eSpark-Backup/ezlo-switchbox/Deliverables/Renderings/3D_Top_View.PNG

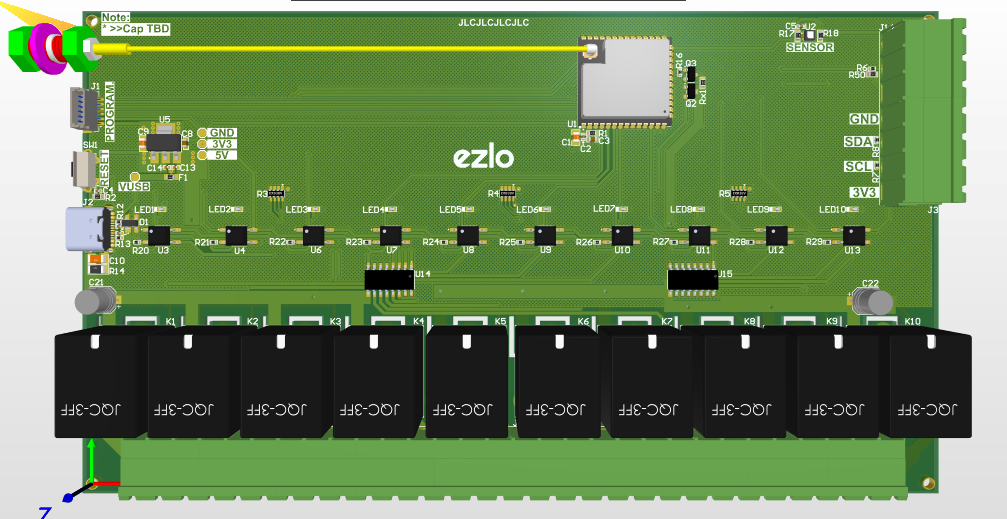
Deliverables/Renderings/3D_Top_View.PNG
