eSpark-Backup/ezlo-switchbox/Deliverables/Renderings/3D_Bottom_View.PNG

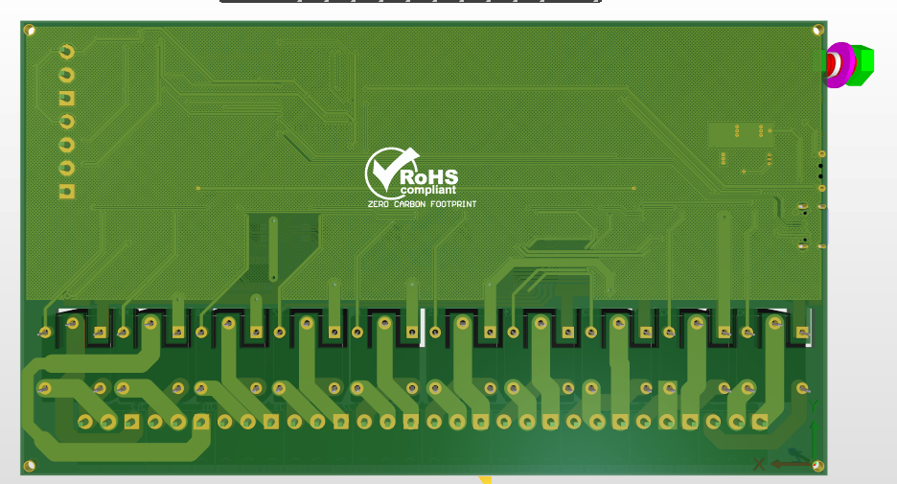
Deliverables/Renderings/3D_Bottom_View.PNG
