eSpark-Backup/ezlo-switchbox/README.md

# ezlo-switchbox
 To develop a basic Switch Box controlled by ESP32 for EzloPi compatability and has 10 relays to install and control distribution boxes
