eSpark-Backup/ezlo-switchbox/Deliverables/Renderings/2D_Top_View.PNG

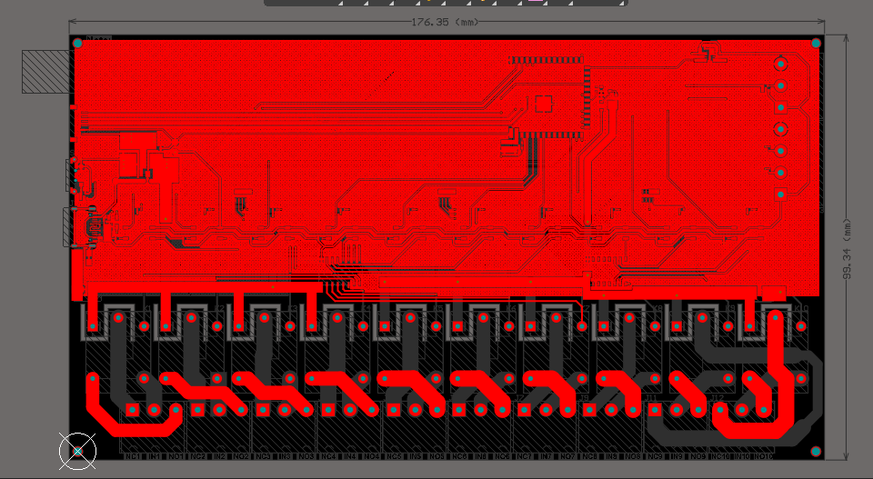
Deliverables/Renderings/2D_Top_View.PNG
