eSpark-Backup/ezlo-switchbox/Deliverables/Renderings/3D_Front Edge_View.PNG

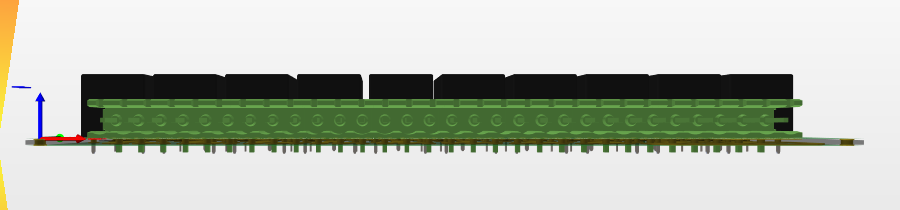
Deliverables/Renderings/3D_Front Edge_View.PNG
