eSpark-Backup/ezlo-switchbox/Deliverables/Renderings/3D_Isometric_View.PNG

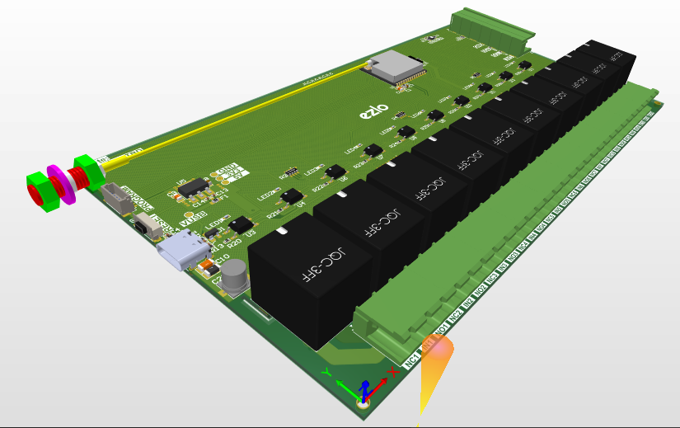
Deliverables/Renderings/3D_Isometric_View.PNG
