eSpark-Backup/ezlo-switchbox/Deliverables/BOM/eSpark_BOM.xlsx

Sheet: 10 Boards
 |  | Component list |  | Bill of Materials for Project [switch-box]
 |  | Source Data From: |  | switch-box
 |  | Project: |  | switch-box
 |  | Variant: |  | None
# | Item Type | Designator | Description | Footprint | Manufacturer Part Number | Manufacturer | Alternate Part Number | LCSC Part Number | Value | Quantity | Quantity (10 Boards) | MOQ (10 Boards) | Links | Unit Cost (10 Boards) | Total Cost (10 Boards) | Remarks | Reviewer Remarks
1 | Capacitor | C1, C9 | CAP CER 22UF 25V X5R 0805 | Cap-0805 | CL21A226MAYNNNE | Samsung | - | C602037 | 22uF | 2 | 20 | 40 | LCSC (https://www.lcsc.com/product-detail/Multilayer-Ceramic-Capacitors-MLCC-SMD-SMT_Samsung-Electro-Mechanics-CL21A226MAYNNNE_C602037.html) | $0.0239 | $0.9560
2 | Capacitor | C2, C4, C5 | CAP CER 0.1UF 50V X5R 0402 | Cap-0402 | ~~C1005X5R1H104K050BB~~ | TDK | CC0402KRX7R9BB104 | C131394 | 0.1uF | 3 | 30 | 100 | LCSC (https://www.lcsc.com/product-detail/Multilayer-Ceramic-Capacitors-MLCC-SMD-SMT_YAGEO-CC0402KRX7R9BB104_C131394.html) | $0.0030 | $0.3000
3 | Capacitor | C3 | CAP CER 1UF 25V X5R 0603 | Cap-0603 | CC0603KRX5R8BB105 | Yageo | - | C14664 | 1uF | 1 | 10 | 100 | LCSC (https://www.lcsc.com/product-detail/Multilayer-Ceramic-Capacitors-MLCC-SMD-SMT_YAGEO-CC0603KRX5R8BB105_C14664.html) | $0.0046 | $0.4600
4 | Capacitor | C8 | CAP CER 10UF 25V X5R 0603 | Cap-0603 | ~~C1608X5R1E106M080AC~~ | TDK | CL10A106MA8NRNC | C96446 | 10uF | 1 | 10 | 20 | LCSC (https://www.lcsc.com/product-detail/Multilayer-Ceramic-Capacitors-MLCC-SMD-SMT_Samsung-Electro-Mechanics-CL10A106MA8NRNC_C96446.html) | $0.0234 | $0.4680
5 | Capacitor | C10 | CAP CER 4700PF 1KV X7R 1206 | Cap-1206 | CC1206KKX7RCBB472 | Yageo | - | C107198 | 4.7nF | 1 | 10 | 50 | LCSC (https://www.lcsc.com/product-detail/Multilayer-Ceramic-Capacitors-MLCC-SMD-SMT_YAGEO-CC1206KKX7RCBB472_C107198.html) | $0.0156 | $0.7800
6 | Capacitor | C11, C12 | DO Not Mount | Cap-0402 | - | - | - | - | - | 2 | 20 | - | - | - | - | - | -
7 | Capacitor | C13 | CAP CER 1UF 10V X5R 0402 | Cap-0402 | CC0402KRX5R6BB105 | Yageo | - | C106254 | 1uF | 1 | 10 | 100 | LCSC (https://www.lcsc.com/product-detail/Multilayer-Ceramic-Capacitors-MLCC-SMD-SMT_YAGEO-CC0402KRX5R6BB105_C106254.html) | $0.0020 | $0.2000
8 | Capacitor | C14 | CAP CER 4.7UF 10V X5R 0402 | Cap-0402 | CC0402KRX5R6BB475 | Yageo | - | C326586 | 4.7uF | 1 | 10 | 50 | LCSC (https://www.lcsc.com/product-detail/Multilayer-Ceramic-Capacitors-MLCC-SMD-SMT_YAGEO-CC0402KRX5R6BB475_C326586.html) | $0.0139 | $0.6950
9 | Capacitor | C21, C22 | -45℃~+105℃ 2000hrs@105℃ 47uF 5.4mm 16V 5mm ±20% SMD,D5xL5.4mm Aluminum Electrolytic Capacitors - SMD ROHS | SMD,D5xL5.4mm | RVT1C470M0505 | ROQANG | - | C72515 | 47uF | 2 | 20 | 40 | LCSC (https://www.lcsc.com/product-detail/Aluminum-Electrolytic-Capacitors-SMD_ROQANG-RVT1C470M0505_C72515.html) | $0.0275 | $1.1000
10 | Diode | D1 | ESD Suppressor TVS 5.5V 4-Pin(3+Tab) SOT-143 T/R | SOT-143-4_ | SP0503BAHTG | Littelfuse | - | C3029025 | - | 1 | 10 | 15 | LCSC (https://www.lcsc.com/product-detail/ESD-Protection-Devices_MSKSEMI-SP0503BAHTG-MS_C3029025.html) | $0.0654 | $0.9810
11 | Fuse | F1 | 6V 1A 50A 1W -40℃~+85℃ 2A 9mΩ 0.5s 80mΩ 0603 Resettable Fuses ROHS | fuse-0603 | BSMD0603L-100 | BHFUSE | - | C2757929 | - | 1 | 10 | 15 | LCSC (https://www.lcsc.com/product-detail/Resettable-Fuses_BHFUSE-BSMD0603L-100_C2757929.html) | $0.0716 | $1.0740
12 | JST Connector | J1 | 1x6P SH 1 1mm 6 SMD,P=1mm Wire To Board / Wire To Wire Connector ROHS | Custom | C145963 | BOOMELE | - | C145963 | - | 1 | 10 | 12 | LCSC (https://www.lcsc.com/product-detail/Wire-To-Board-Wire-To-Wire-Connector_BOOMELE-Boom-Precision-Elec-C145963_C145963.html) | $0.0720 | $0.8640
13 | USB Connector | J2 | 250mA 1 16 Female Type-C SMD USB Connectors ROHS | Custom | TYPE-C-31-M-12 | Korean Hroparts Elec | - | C165948 | - | 1 | 10 | 15 | LCSC (https://www.lcsc.com/product-detail/USB-Connectors_Korean-Hroparts-Elec-TYPE-C-31-M-12_C165948.html) | $0.2276 | $3.4140
14 | Terminal Block | J3 | 450V 17.5A 4 Bend -40℃~+105℃ 1 5.08mm Green Board Edge/Receptacle-Open Push-Pull,P=5.08mm Pluggable System Terminal Block ROHS | Custom | DB2ER-5.08-4P-GN | DIBO | - | C395752 | - | 1 | 10 | 15 | LCSC (https://www.lcsc.com/product-detail/Pluggable-System-Terminal-Block_DIBO-DB2ER-5-08-4P-GN_C395752.html) | $0.0656 | $0.9840
15 | Terminal Block | J4, J5, J6, J7, J8, J9, J10, J11, J12, J13, J14 | 3 Bend 1 5.08mm Green Board Edge/Receptacle-Open Push-Pull,P=5.08mm Pluggable System Terminal Block ROHS | Custom | WJ2EDGR-5.08-3P | Ningbo Kangnex Elec | - | C70914 | - | 11 | 110 | 120 | LCSC (https://www.lcsc.com/product-detail/Pluggable-System-Terminal-Block_Ningbo-Kangnex-Elec-WJ2EDGR-5-08-3P_C70914.html) | $0.0461 | $5.5320
16 | Relay | K1, K2, K3, K4, K5, K6, K7, K8, K9, K10 | AgCdO 5V 10A SPDT (1 Form C) Electromagnetic Relay-Single Coil Plugin Power Relays ROHS | Custom | JQC-3FF/005-1ZS(551) | HF(Xiamen Hongfa Electroacoustic) | - | C9221 | - | 10 | 100 | 105 | LCSC (https://www.lcsc.com/product-detail/Power-Relays_HF-Xiamen-Hongfa-Electroacoustic-JQC-3FF-005-1ZS-551_C9221.html) | $0.2578 | $27.0690
17 | LED | LED1, LED2, LED3, LED4, LED5, LED6, LED7, LED8, LED9, LED10 | Green 520~535nm 0402 Light Emitting Diodes (LED) RoHS | LED-0402 | 16-213/GHC-YR1S1/3T | Everlight Elec | - | C74338 | - | 10 | 100 | 110 | LCSC (https://www.lcsc.com/product-detail/Light-Emitting-Diodes-LED_Everlight-Elec-16-213-GHC-YR1S1-3T_C74338.html) | $0.0679 | $7.4690
18 | Test Point | P2, P3, P14, P15 | Test Point ON | Custom | Test-point | - | - | - | - | 4 | 40 | - | - | - | -
19 | Mosfet | Q2 | MOSFET P-CH 12V 2.6A SUPERSOT3 | SOT-23 | FDN306P | ON Semiconductor / Fairchild | - | C725031 | - | 1 | 10 | 15 | LCSC (https://www.lcsc.com/product-detail/MOSFETs_VBsemi-Elec-FDN306P-VB_C725031.html) | $0.0674 | $1.0110
20 | Mosfet | Q3 | Trans Gp Bjt NPN 25V 1.5A 300MW 3-PIN SOT-23 T/r | SOT-23 | SS8050-G | Comchip | - | C105433 | - | 1 | 10 | 50 | LCSC (https://www.lcsc.com/product-detail/Bipolar-Transistors-BJT_Jiangsu-Changjing-Electronics-Technology-Co-Ltd-S8050_C105433.html) | $0.0147 | $0.7350
21 | Resistor | R1, R2, R17, R18, R50, Rx1 | RES 10K OHM 1% 1/10W 0603 | RES-0603 | RC0603FR-0710KL | YAGEO | - | C98220 | 10K | 6 | 60 | 100 | LCSC (https://www.lcsc.com/product-detail/Chip-Resistor-Surface-Mount_YAGEO-RC0603FR-0710KL_C98220.html) | $0.0010 | $0.1000
22 | Resistor Array | R3, R4, R5 | 4 8 ±5% 330Ω 62.5mW ±200ppm/℃ 0603x4 Resistor Networks & Arrays ROHS | Resistor 0603x4 | 4D03WGJ0331T5E | UNI-ROYAL(Uniroyal Elec) | - | C12018 | 330R | 3 | 30 | 100 | LCSC (https://www.lcsc.com/product-detail/span-style-background-color-ff0-Resistor-span-Networks-Arrays_UNI-ROYAL-Uniroyal-Elec-4D03WGJ0331T5E_C12018.html) | $0.0069 | $0.6900
23 | Resistor | R6, R7, R8 | RES SMD 47 OHM 1% 1/10W 0402 | Res-0402 | ERJ-2RKF47R0X | Panasonic | - | C413056 | 47R | 3 | 30 | 50 | LCSC (https://www.lcsc.com/product-detail/Chip-Resistor-Surface-Mount_PANASONIC-ERJ2RKF47R0X_C413056.html) | $0.0078 | $0.3900
24 | Resistor | R12, R13 | RES SMD 5.1 KOHM 1% 1/5W 0402 | Res-0402 | ~~ERJ-PA2F5101X~~ | Panasonic | RC0402JR-075K1L | C105873 | 5.1K | 2 | 20 | 100 | LCSC (https://www.lcsc.com/product-detail/Chip-span-style-background-color-ff0-Resistor-span-Surface-Mount_YAGEO-RC0402JR-075K1L_C105873.html) | $0.0005 | $0.0500
25 | Resistor | R14 | RES SMD 1M OHM 1% 1/10W 0603 | Res-0603 | RC0603FR-071ML | Yageo | - | C105578 | 1M | 1 | 10 | 100 | LCSC (https://www.lcsc.com/product-detail/Chip-Resistor-Surface-Mount_YAGEO-RC0603FR-071ML_C105578.html) | $0.0014 | $0.1400
26 | Resistor | R16 | RES 100K OHM 1% 1/16W 0402 | Res-0402 | RC0402FR-07100KL | Yageo | - | C60491 | 100K | 1 | 10 | 100 | LCSC (https://www.lcsc.com/product-detail/Chip-Resistor-Surface-Mount_YAGEO-RC0402FR-07100KL_C60491.html) | $0.0005 | $0.0500
27 | Resistor | R20, R21, R22, R23, R24, R25, R26, R27, R28, R29 | RES 100 OHM 1% 1/16W 0402 | Res-0402 | RC0402FR-07100RL | Yageo | - | C2935235 | 100R | 10 | 100 | 200 | LCSC (https://www.lcsc.com/product-detail/Chip-Resistor-Surface-Mount_YAGEO-RC0402FR-07100RL_C2935235.html) | $0.0007 | $0.1400
28 | Switch | SW1 | 3.5mm 3.5mm SMDSplicing Black Rectangle button 50mA Surface Mount 7mm SPST 100MΩ 20000 12V 250gf@±50gf SMD Tactile Switches ROHS | Custom | YTS-B003-2A | YIYUAN | - | C2910695 | - | 1 | 10 | 20 | LCSC (https://www.lcsc.com/product-detail/Tactile-Switches_YIYUAN-YTS-B003-2A_C2910695.html) | $0.0180 | $0.3600
29 | Module | U1 | RF TXRX MOD WIFI SURFACE MOUNT | 41-SMD UFL Module | ESP32-S3-WROOM-1U-N4 | Espressif Systems | - | C2980296 | - | 1 | 10 | 11 | LCSC (https://www.lcsc.com/product-detail/WiFi-Modules_Espressif-Systems-ESP32-S3-WROOM-1U-N4_C2980296.html) | $3.3553 | $36.9083
30 | Temperature & Humidity Sensor | U2 | DFN-6-EP(2x2) Temperature and Humidity Sensor ROHS | DFN-6-EP(2x2) | GXHTC3 | GXCAS | - | C2837688 | - | 1 | 10 | 11 | LCSC (https://www.lcsc.com/product-detail/Temperature-and-Humidity-Sensor_GXCAS-GXHTC3_C2837688.html) | $0.7096 | $7.8056
31 | Optocoupler | U3, U4, U6, U7, U8, U9, U10, U11, U12, U13 | Optoisolator Transistor Output 3750Vrms 1 Channel | SOP-4_2.54 | IS181GB | Isocom | - | C84196 | - | 10 | 100 | 105 | LCSC (https://www.lcsc.com/product-detail/Optocouplers-Phototransistor-Output_Isocom-Components-IS181GB_C84196.html) | $0.1175 | $12.3375
32 | IC | U5 | IC REG LINEAR 3.3V 1.2A SOT223 | SOT- 223 | LDL1117S33R | STMicroelectronics | - | C435835 | - | 1 | 10 | 15 | LCSC (https://www.lcsc.com/product-detail/Linear-Voltage-Regulators-LDO_STMicroelectronics-LDL1117S33R_C435835.html) | $0.3513 | $5.2695
33 | IC | U14, U15 | TRANS 7NPN DARL 50V 0.5A 16SOIC | 16-SOIC | ULN2003AD | Mixic | - | C181730 | - | 2 | 20 | 25 | LCSC (https://www.lcsc.com/product-detail/Darlington-Transistor-Arrays_Mixic-ULN2003A_C181730.html) | $0.0812 | $2.0300
34 | Terminal Block | - | 3 1 5.08mm Green Plug P=5.08mm Pluggable System Terminal Block ROHS | Custom | WJ2EDGK-5.08-3P | Ningbo Kangnex Elec | - | C71371 | - | 11 | 110 | 115 | LCSC (https://www.lcsc.com/product-detail/Pluggable-System-span-style-background-color-ff0-Terminal-span-Block_Ningbo-Kangnex-Elec-WJ2EDGK-5-08-3P_C71371.html) | $0.1517 | $17.4455
35 | Terminal Block | - | 320V 15A 4 2.5 1 12~24 5.08mm Green Plug P=5.08mm Pluggable System Terminal Block ROHS | Custom | KF2EDGK-5.08-4P-AA | Cixi Kefa Elec | - | C440882 | - | 1 | 10 | 15 | LCSC (https://www.lcsc.com/product-detail/Pluggable-System-span-style-background-color-ff0-Terminal-span-Block_Cixi-Kefa-Elec-KF2EDGK-5-08-4P-AA_C440882.html) | $0.3461 | $5.1915
36 | SMA Cable | - | 100mm IPEX to SMA 1Gen - Radio Frequency Cable ROHS | Custom | BWIPX1-SMA-1.13L100 | BAT WIRELESS | - | C784403 | - | 1 | 10 | 11 | LCSC (https://www.lcsc.com/product-detail/_BAT-WIRELESS-_C784403.html) | $0.6832 | $7.5152
37 | Antenna | - | 13x200mm Antennas ROHS | Custom | TX2400-JKD-20 | ZIISOR | - | C454911 | - | 1 | 10 | 11 | LCSC (https://www.lcsc.com/product-detail/_ZIISOR-_C454911.html) | $0.9610 | $10.5710
 |  |  |  |  |  |  |  |  |  |  |  | Total Component Cost |  |  | $161.09
 |  |  |  |  |  |  |  |  |  |  |  | Single Board Cost |  |  | $16.11

Sheet: 1000 Boards
 |  | Component list |  | Bill of Materials for Project [switch-box.PrjPcb]
 |  | Source Data From: |  | switch-box
 |  | Project: |  | switch-box
 |  | Variant: |  | None
# | Item Type | Designator | Description | Footprint | Manufacturer Part Number | Manufacturer | Alternate Part Number | LCSC Part Number | Value | Quantity | Quantity (1000 Boards) | MOQ (1000 Boards) | Links | Unit Cost (1000 Boards) | Total Cost (1000 Boards) | Remarks | Reviewer Remarks
1 | Capacitor | C1, C9 | CAP CER 22UF 25V X5R 0805 | Cap-0805 | CL21A226MAYNNNE | Samsung | - | C602037 | 22uF | 2 | 2000 | 2060 | LCSC (https://www.lcsc.com/product-detail/Multilayer-Ceramic-Capacitors-MLCC-SMD-SMT_Samsung-Electro-Mechanics-CL21A226MAYNNNE_C602037.html) | $0.0142 | $29.2520
2 | Capacitor | C2, C4, C5 | CAP CER 0.1UF 50V X5R 0402 | Cap-0402 | ~~C1005X5R1H104K050BB~~ | TDK | CC0402KRX7R9BB104 | C131394 | 0.1uF | 3 | 3000 | 3100 | LCSC (https://www.lcsc.com/product-detail/Multilayer-Ceramic-Capacitors-MLCC-SMD-SMT_YAGEO-CC0402KRX7R9BB104_C131394.html) | $0.0020 | $6.2000
3 | Capacitor | C3 | CAP CER 1UF 25V X5R 0603 | Cap-0603 | CC0603KRX5R8BB105 | Yageo | - | C14664 | 1uF | 1 | 1000 | 1100 | LCSC (https://www.lcsc.com/product-detail/Multilayer-Ceramic-Capacitors-MLCC-SMD-SMT_YAGEO-CC0603KRX5R8BB105_C14664.html) | $0.0036 | $3.9600
4 | Capacitor | C8 | CAP CER 10UF 25V X5R 0603 | Cap-0603 | ~~C1608X5R1E106M080AC~~ | TDK | CL10A106MA8NRNC | C96446 | 10uF | 1 | 1000 | 1060 | LCSC (https://www.lcsc.com/product-detail/Multilayer-Ceramic-Capacitors-MLCC-SMD-SMT_Samsung-Electro-Mechanics-CL10A106MA8NRNC_C96446.html) | $0.0234 | $24.8040
5 | Capacitor | C10 | CAP CER 4700PF 1KV X7R 1206 | Cap-1206 | CC1206KKX7RCBB472 | Yageo | - | C107198 | 4.7nF | 1 | 1000 | 1050 | LCSC (https://www.lcsc.com/product-detail/Multilayer-Ceramic-Capacitors-MLCC-SMD-SMT_YAGEO-CC1206KKX7RCBB472_C107198.html) | $0.0127 | $13.3350
6 | Capacitor | C11, C12 | DO Not Mount | Cap-0402 | - | - | - | - | - | 2 | 2000 | - | - | - | - | - | -
7 | Capacitor | C13 | CAP CER 1UF 10V X5R 0402 | Cap-0402 | CC0402KRX5R6BB105 | Yageo | - | C106254 | 1uF | 1 | 1000 | 1100 | LCSC (https://www.lcsc.com/product-detail/Multilayer-Ceramic-Capacitors-MLCC-SMD-SMT_YAGEO-CC0402KRX5R6BB105_C106254.html) | $0.0016 | $1.7600
8 | Capacitor | C14 | CAP CER 4.7UF 10V X5R 0402 | Cap-0402 | CC0402KRX5R6BB475 | Yageo | - | C326586 | 4.7uF | 1 | 1000 | 1050 | LCSC (https://www.lcsc.com/product-detail/Multilayer-Ceramic-Capacitors-MLCC-SMD-SMT_YAGEO-CC0402KRX5R6BB475_C326586.html) | $0.0113 | $11.8650
9 | Capacitor | C21, C22 | -45℃~+105℃ 2000hrs@105℃ 47uF 5.4mm 16V 5mm ±20% SMD,D5xL5.4mm Aluminum Electrolytic Capacitors - SMD ROHS | SMD,D5xL5.4mm | RVT1C470M0505 | ROQANG | - | C72515 | 47uF | 2 | 2000 | 2060 | LCSC (https://www.lcsc.com/product-detail/Aluminum-Electrolytic-Capacitors-SMD_ROQANG-RVT1C470M0505_C72515.html) | $0.0169 | $34.8140
10 | Diode | D1 | ESD Suppressor TVS 5.5V 4-Pin(3+Tab) SOT-143 T/R | SOT-143-4_ | SP0503BAHTG | Littelfuse | - | C3029025 | - | 1 | 1000 | 1050 | LCSC (https://www.lcsc.com/product-detail/ESD-Protection-Devices_MSKSEMI-SP0503BAHTG-MS_C3029025.html) | $0.0425 | $44.6250
11 | Fuse | F1 | 6V 1A 50A 1W -40℃~+85℃ 2A 9mΩ 0.5s 80mΩ 0603 Resettable Fuses ROHS | fuse-0603 | BSMD0603L-100 | BHFUSE | - | C2757929 | - | 1 | 1000 | 1050 | LCSC (https://www.lcsc.com/product-detail/Resettable-Fuses_BHFUSE-BSMD0603L-100_C2757929.html) | $0.0471 | $49.4550
12 | JST Connector | J1 | 1x6P SH 1 1mm 6 SMD,P=1mm Wire To Board / Wire To Wire Connector ROHS | Custom | C145963 | BOOMELE | - | C145963 | - | 1 | 1000 | 1020 | LCSC (https://www.lcsc.com/product-detail/Wire-To-Board-Wire-To-Wire-Connector_BOOMELE-Boom-Precision-Elec-C145963_C145963.html) | $0.0529 | $53.9580
13 | USB Connector | J2 | 250mA 1 16 Female Type-C SMD USB Connectors ROHS | Custom | TYPE-C-31-M-12 | Korean Hroparts Elec | - | C165948 | - | 1 | 1000 | 1050 | LCSC (https://www.lcsc.com/product-detail/USB-Connectors_Korean-Hroparts-Elec-TYPE-C-31-M-12_C165948.html) | $0.1074 | $112.7700
14 | Terminal Block | J3 | 450V 17.5A 4 Bend -40℃~+105℃ 1 5.08mm Green Board Edge/Receptacle-Open Push-Pull,P=5.08mm Pluggable System Terminal Block ROHS | Custom | DB2ER-5.08-4P-GN | DIBO | - | C395752 | - | 1 | 1000 | 1050 | LCSC (https://www.lcsc.com/product-detail/Pluggable-System-Terminal-Block_DIBO-DB2ER-5-08-4P-GN_C395752.html) | $0.0420 | $44.1000
15 | Terminal Block | J4, J5, J6, J7, J8, J9, J10, J11, J12, J13, J14 | 3 Bend 1 5.08mm Green Board Edge/Receptacle-Open Push-Pull,P=5.08mm Pluggable System Terminal Block ROHS | Custom | WJ2EDGR-5.08-3P | Ningbo Kangnex Elec | - | C70914 | - | 11 | 11000 | 11100 | LCSC (https://www.lcsc.com/product-detail/Pluggable-System-Terminal-Block_Ningbo-Kangnex-Elec-WJ2EDGR-5-08-3P_C70914.html) | $0.0326 | $361.8600
16 | Relay | K1, K2, K3, K4, K5, K6, K7, K8, K9, K10 | AgCdO 5V 10A SPDT (1 Form C) Electromagnetic Relay-Single Coil Plugin Power Relays ROHS | Custom | JQC-3FF/005-1ZS(551) | HF(Xiamen Hongfa Electroacoustic) | - | C9221 | - | 10 | 10000 | 10100 | LCSC (https://www.lcsc.com/product-detail/Power-Relays_HF-Xiamen-Hongfa-Electroacoustic-JQC-3FF-005-1ZS-551_C9221.html) | $0.2408 | $2432.0800
17 | LED | LED1, LED2, LED3, LED4, LED5, LED6, LED7, LED8, LED9, LED10 | Green 520~535nm 0402 Light Emitting Diodes (LED) RoHS | LED-0402 | 16-213/GHC-YR1S1/3T | Everlight Elec | - | C74338 | - | 10 | 10000 | 10100 | LCSC (https://www.lcsc.com/product-detail/Light-Emitting-Diodes-LED_Everlight-Elec-16-213-GHC-YR1S1-3T_C74338.html) | $0.0527 | $532.2700
18 | Test Point | P2, P3, P14, P15 | Test Point ON | Custom | Test-point | - | - | - | - | 4 | 4000 | - | - | - | -
19 | Mosfet | Q2 | MOSFET P-CH 12V 2.6A SUPERSOT3 | SOT-23 | FDN306P | ON Semiconductor / Fairchild | - | C725031 | - | 1 | 1000 | 1050 | LCSC (https://www.lcsc.com/product-detail/MOSFETs_VBsemi-Elec-FDN306P-VB_C725031.html) | $0.0431 | $45.2550
20 | Mosfet | Q3 | Trans Gp Bjt NPN 25V 1.5A 300MW 3-PIN SOT-23 T/r | SOT-23 | SS8050-G | Comchip | - | C105433 | - | 1 | 1000 | 1050 | LCSC (https://www.lcsc.com/product-detail/Bipolar-Transistors-BJT_Jiangsu-Changjing-Electronics-Technology-Co-Ltd-S8050_C105433.html) | $0.0115 | $12.0750
21 | Resistor | R1, R2, R17, R18, R50, Rx1 | RES 10K OHM 1% 1/10W 0603 | RES-0603 | RC0603FR-0710KL | YAGEO | - | C98220 | 10K | 6 | 6000 | 6100 | LCSC (https://www.lcsc.com/product-detail/Chip-Resistor-Surface-Mount_YAGEO-RC0603FR-0710KL_C98220.html) | $0.0007 | $4.2700
22 | Resistor Array | R3, R4, R5 | 4 8 ±5% 330Ω 62.5mW ±200ppm/℃ 0603x4 Resistor Networks & Arrays ROHS | Resistor 0603x4 | 4D03WGJ0331T5E | UNI-ROYAL(Uniroyal Elec) | - | C12018 | 330R | 3 | 3000 | 3100 | LCSC (https://www.lcsc.com/product-detail/span-style-background-color-ff0-Resistor-span-Networks-Arrays_UNI-ROYAL-Uniroyal-Elec-4D03WGJ0331T5E_C12018.html) | $0.0056 | $17.3600
23 | Resistor | R6, R7, R8 | RES SMD 47 OHM 1% 1/10W 0402 | Res-0402 | ERJ-2RKF47R0X | Panasonic | - | C413056 | 47R | 3 | 3000 | 3050 | LCSC (https://www.lcsc.com/product-detail/Chip-Resistor-Surface-Mount_PANASONIC-ERJ2RKF47R0X_C413056.html) | $0.0059 | $17.9950
24 | Resistor | R12, R13 | RES SMD 5.1 KOHM 1% 1/5W 0402 | Res-0402 | ~~ERJ-PA2F5101X~~ | Panasonic | RC0402JR-075K1L | C105873 | 5.1K | 2 | 2000 | 2100 | LCSC (https://www.lcsc.com/product-detail/Chip-span-style-background-color-ff0-Resistor-span-Surface-Mount_YAGEO-RC0402JR-075K1L_C105873.html) | $0.0004 | $0.8400
25 | Resistor | R14 | RES SMD 1M OHM 1% 1/10W 0603 | Res-0603 | RC0603FR-071ML | Yageo | - | C105578 | 1M | 1 | 1000 | 1100 | LCSC (https://www.lcsc.com/product-detail/Chip-Resistor-Surface-Mount_YAGEO-RC0603FR-071ML_C105578.html) | $0.0011 | $1.2100
26 | Resistor | R16 | RES 100K OHM 1% 1/16W 0402 | Res-0402 | RC0402FR-07100KL | Yageo | - | C60491 | 100K | 1 | 1000 | 1100 | LCSC (https://www.lcsc.com/product-detail/Chip-Resistor-Surface-Mount_YAGEO-RC0402FR-07100KL_C60491.html) | $0.0004 | $0.4400
27 | Resistor | R20, R21, R22, R23, R24, R25, R26, R27, R28, R29 | RES 100 OHM 1% 1/16W 0402 | Res-0402 | RC0402FR-07100RL | Yageo | - | C2935235 | 100R | 10 | 10000 | 10100 | LCSC (https://www.lcsc.com/product-detail/Chip-Resistor-Surface-Mount_YAGEO-RC0402FR-07100RL_C2935235.html) | $0.0004 | $4.0400
28 | Switch | SW1 | 3.5mm 3.5mm SMDSplicing Black Rectangle button 50mA Surface Mount 7mm SPST 100MΩ 20000 12V 250gf@±50gf SMD Tactile Switches ROHS | Custom | YTS-B003-2A | YIYUAN | - | C2910695 | - | 1 | 1000 | 1080 | LCSC (https://www.lcsc.com/product-detail/Tactile-Switches_YIYUAN-YTS-B003-2A_C2910695.html) | $0.0122 | $13.1760
29 | Module | U1 | RF TXRX MOD WIFI SURFACE MOUNT | 41-SMD UFL Module | ESP32-S3-WROOM-1U-N4 | Espressif Systems | - | C2980296 | - | 1 | 1000 | 1020 | LCSC (https://www.lcsc.com/product-detail/WiFi-Modules_Espressif-Systems-ESP32-S3-WROOM-1U-N4_C2980296.html) | $3.2805 | $3346.1100
30 | Temperature & Humidity Sensor | U2 | DFN-6-EP(2x2) Temperature and Humidity Sensor ROHS | DFN-6-EP(2x2) | GXHTC3 | GXCAS | - | C2837688 | - | 1 | 1000 | 1020 | LCSC (https://www.lcsc.com/product-detail/Temperature-and-Humidity-Sensor_GXCAS-GXHTC3_C2837688.html) | $0.4901 | $499.9020
31 | Optocoupler | U3, U4, U6, U7, U8, U9, U10, U11, U12, U13 | Optoisolator Transistor Output 3750Vrms 1 Channel | SOP-4_2.54 | IS181GB | Isocom | - | C84196 | - | 10 | 10000 | 10050 | LCSC (https://www.lcsc.com/product-detail/Optocouplers-Phototransistor-Output_Isocom-Components-IS181GB_C84196.html) | $0.0829 | $833.1450
32 | IC | U5 | IC REG LINEAR 3.3V 1.2A SOT223 | SOT- 223 | LDL1117S33R | STMicroelectronics | - | C435835 | - | 1 | 1000 | 1020 | LCSC (https://www.lcsc.com/product-detail/Linear-Voltage-Regulators-LDO_STMicroelectronics-LDL1117S33R_C435835.html) | $0.2414 | $246.2280
33 | IC | U14, U15 | TRANS 7NPN DARL 50V 0.5A 16SOIC | 16-SOIC | ULN2003AD | Mixic | - | C181730 | - | 2 | 2000 | 20100 | LCSC (https://www.lcsc.com/product-detail/Darlington-Transistor-Arrays_Mixic-ULN2003A_C181730.html) | $0.0484 | $972.8400
 |  |  |  |  |  |  |  |  |  |  |  | Total Component Cost |  |  | $9771.99
 |  |  |  |  |  |  |  |  |  |  |  | Single Board Cost |  |  | $9.77
