eSpark-Backup/ezlo-switchbox/Deliverables/Supporting_Files/switch-box.step

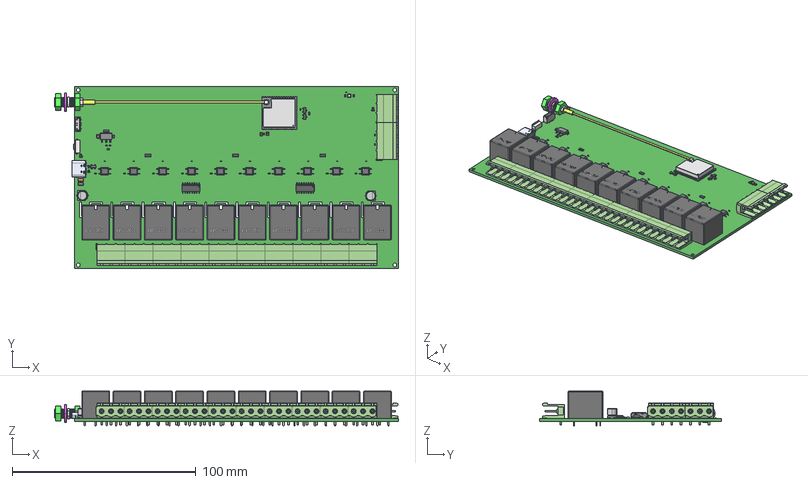
[picture p8: CAD file, 2023-01-02]
Deliverables/Supporting_Files/switch-box.step
187.3 x 99.3 x 19.0 mm
User_Library-R-0603-Array-4-1 x 3
User_Library-1206_SMD_Resistor
282814-3--3DModel-STEP-1_RGB5220458 x 11
capacitor_RGB10066329 x 2
282814-4--3DModel-STEP-1_RGB5220458
TYPE-C-31-M-12
SOLID.step.STEP.dwg.STEP.STEP.dwg
User_Library-RES_1005-0402 x 16
User_Library-SOIC127P600X175-16 x 2
User_Library-SOP-4 x 10
User_Library-SOT-223-1
GXCAS-GXHTC3_C2837688
2009180306_BAT-WIRELESS-BWIPX1-SMA-1-13L100_C784403
ESP32-S3-WROOM-1U--3DModel-STEP-56544
Switch
User_Library-RESC1608X05N x 7
CircuitWorks-SOT-23 x 2
User_Library-LED-0402 x 10
JQC-3FF-005-1ZS-551_C9221 x 10
SP0503BAHTG--3DModel-STEP-56544_(1)
User_Library-Capacitor_0402 x 7
User_Library-1206_SMD_Capacitor
User_Library-0805_SMD_Capacitor x 2
User_Library-CAPC1608X09 x 2
