eSpark-Backup/ezlo-switchbox/(list of files, cad)

Other CAD files:
Deliverables/Supporting_Files/switch-box.DWG
Deliverables/Supporting_Files/switch-box.DXF
