eSpark-Backup/ezlo-switchbox/Deliverables/Schematics/switch-box.pdf

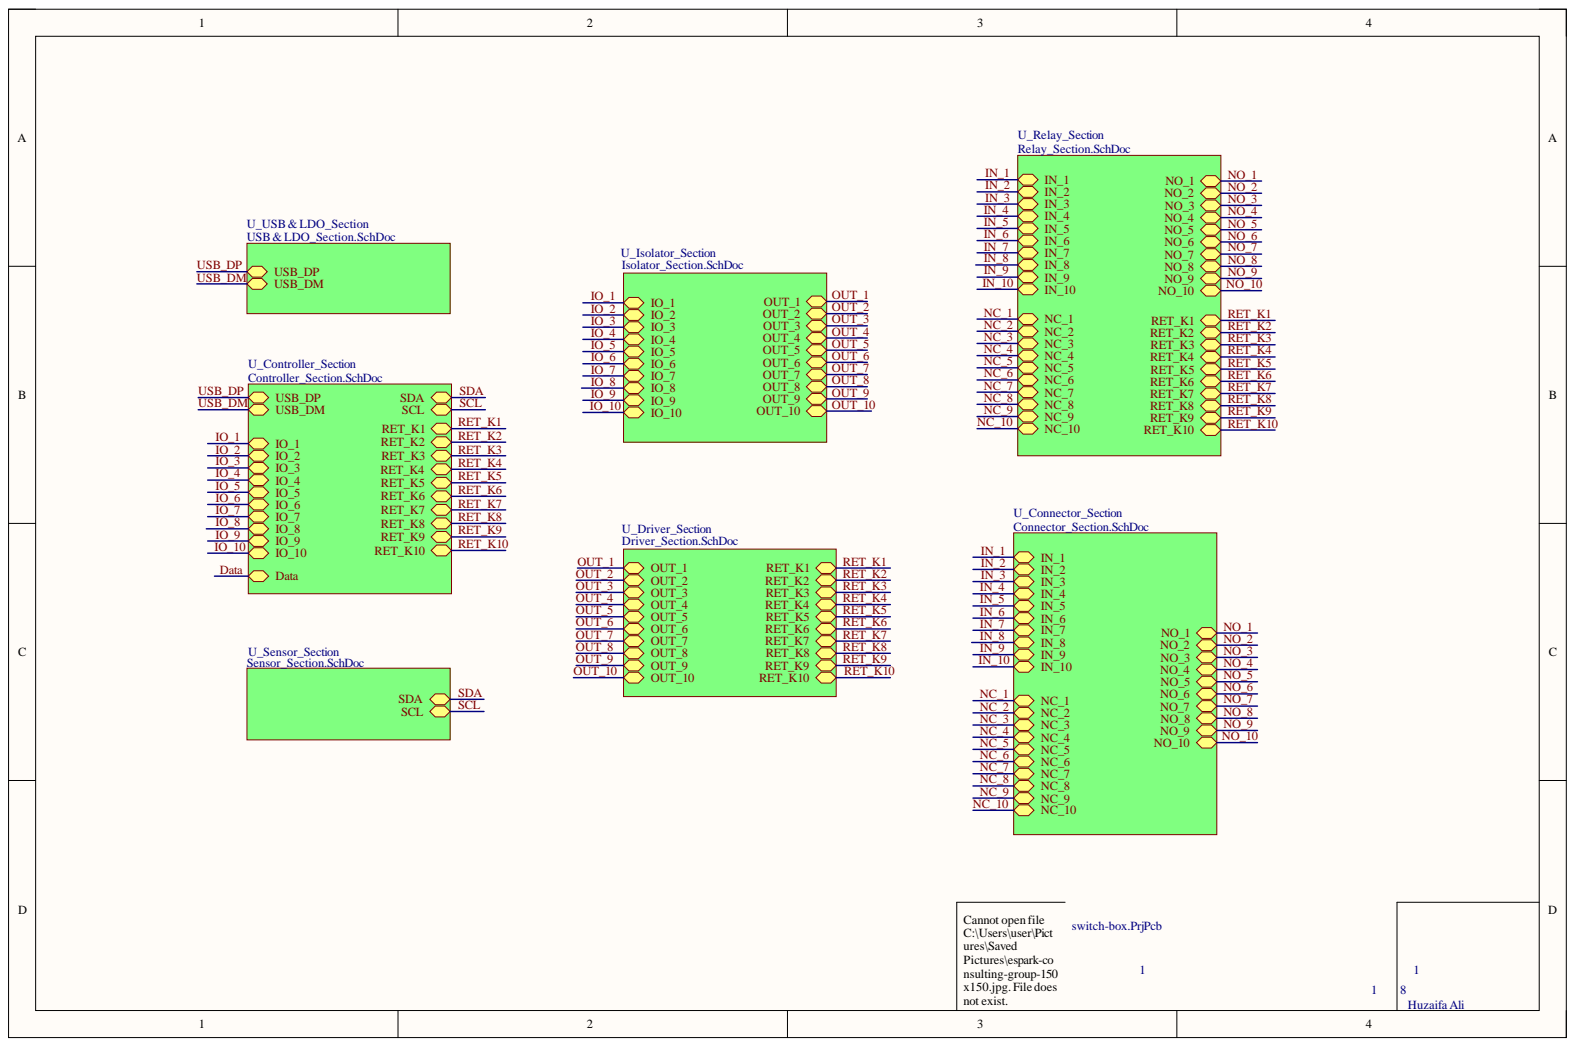
[picture p27: page 1]

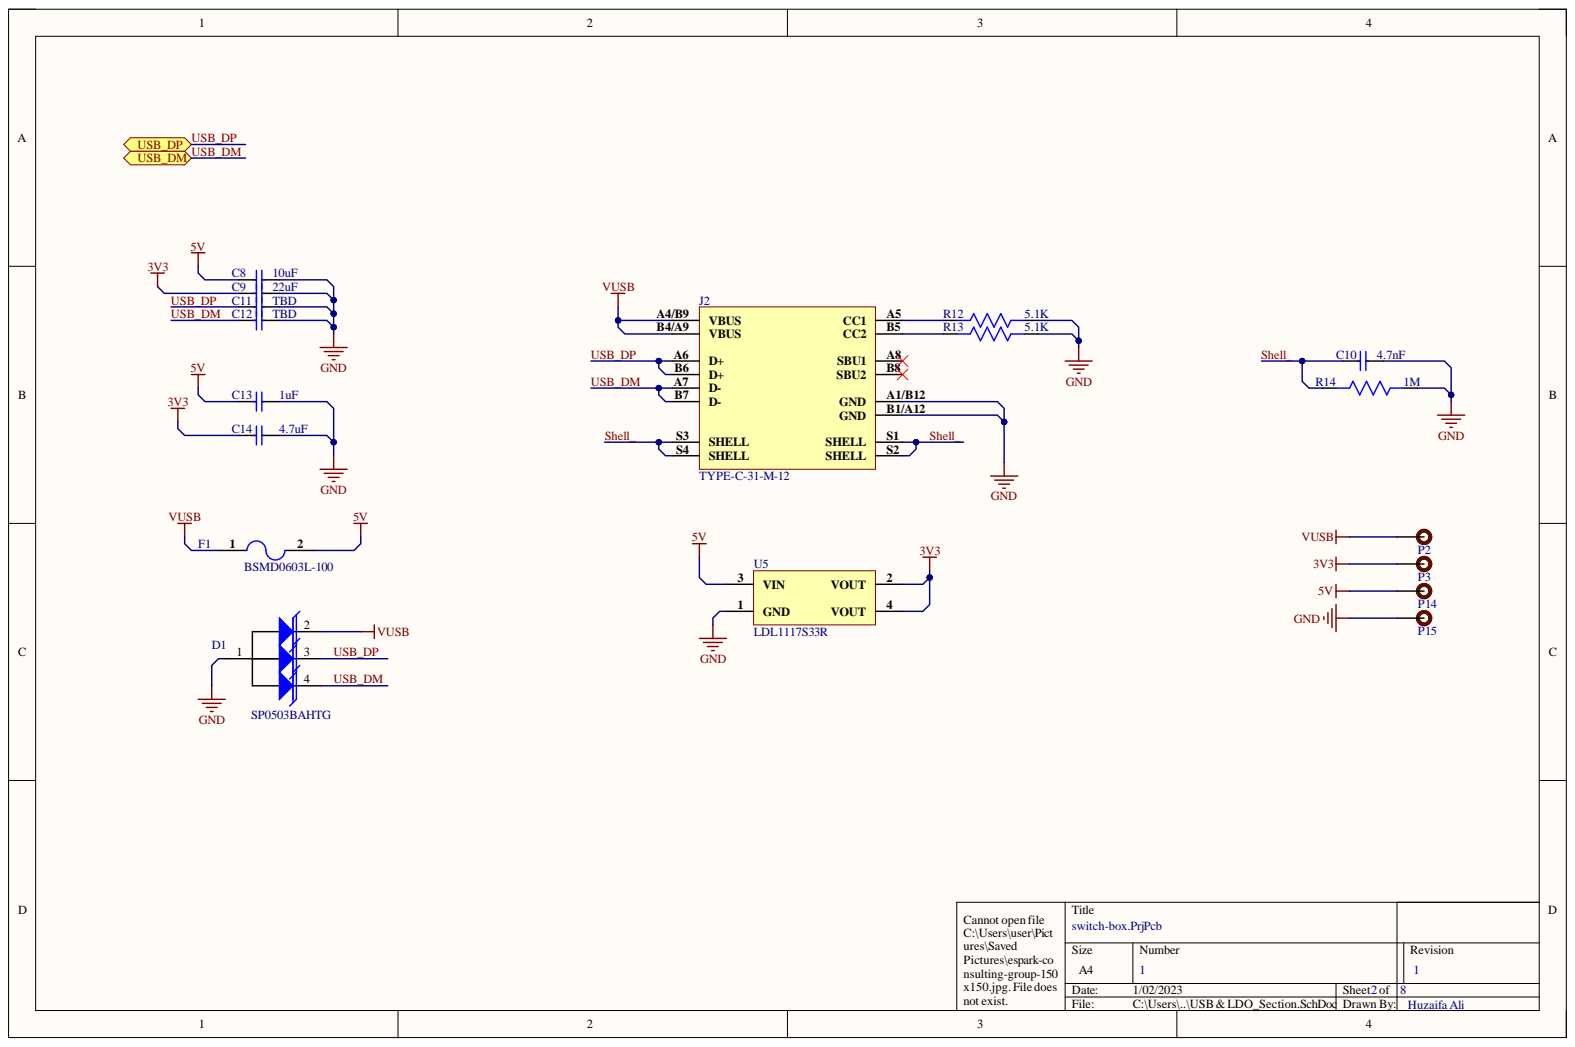
[picture p28: page 2]

C annot open file C:\Use rs\use r \P i c t ur es\S a v ed Pictur es\e s p ark-c o nsulting-group -1 5 0 x150.jpg. File does not exist. | Titl e switch-box. P rj P c b

Siz e A4 | Numb e r 1 | R evisio n 1

Da te : 1/02/202 3 | She et of 2 | 8
File : C:\Use rs\. .\US B& LDO_S e ction. S c hD o c | Dr awn B y | : Huz aifa A li

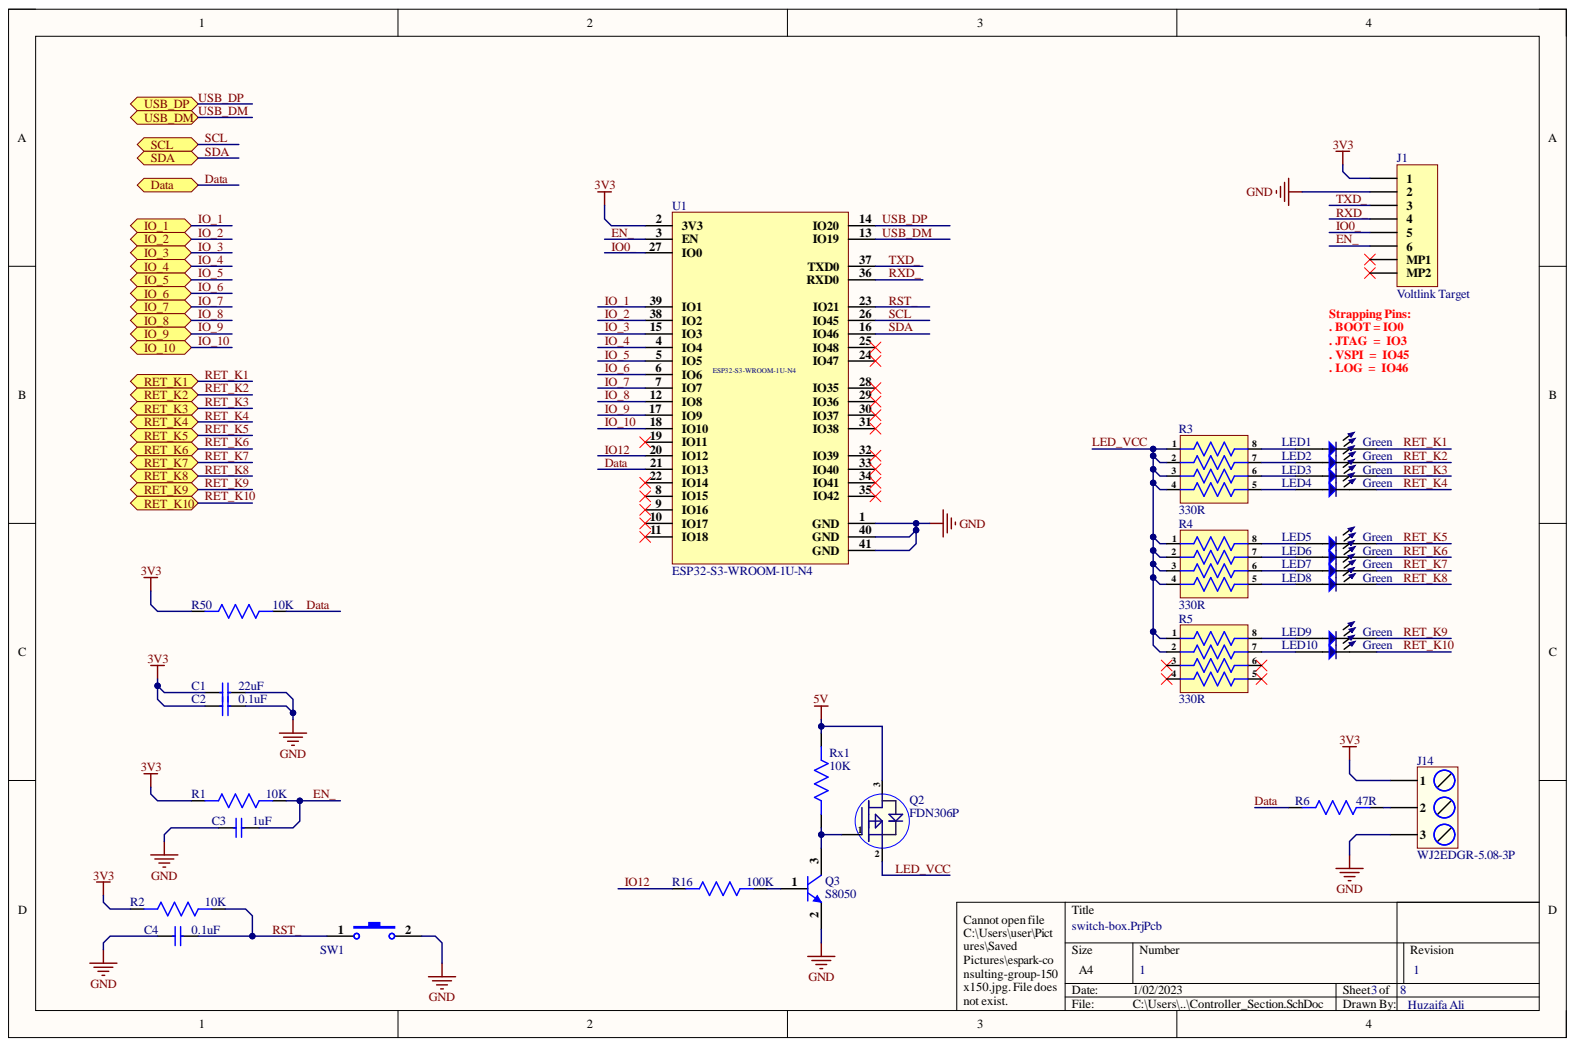
[picture p29: page 3]
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

Siz e A4 | Numb e r 1 | R evisio n 1

Da te : 1/02/202 3 | She et of 3 | 8
File : C:\Use rs\. .\Controlle r_S e cti o n . S c hD o c | Dr awn B y | : Huz aifa A li

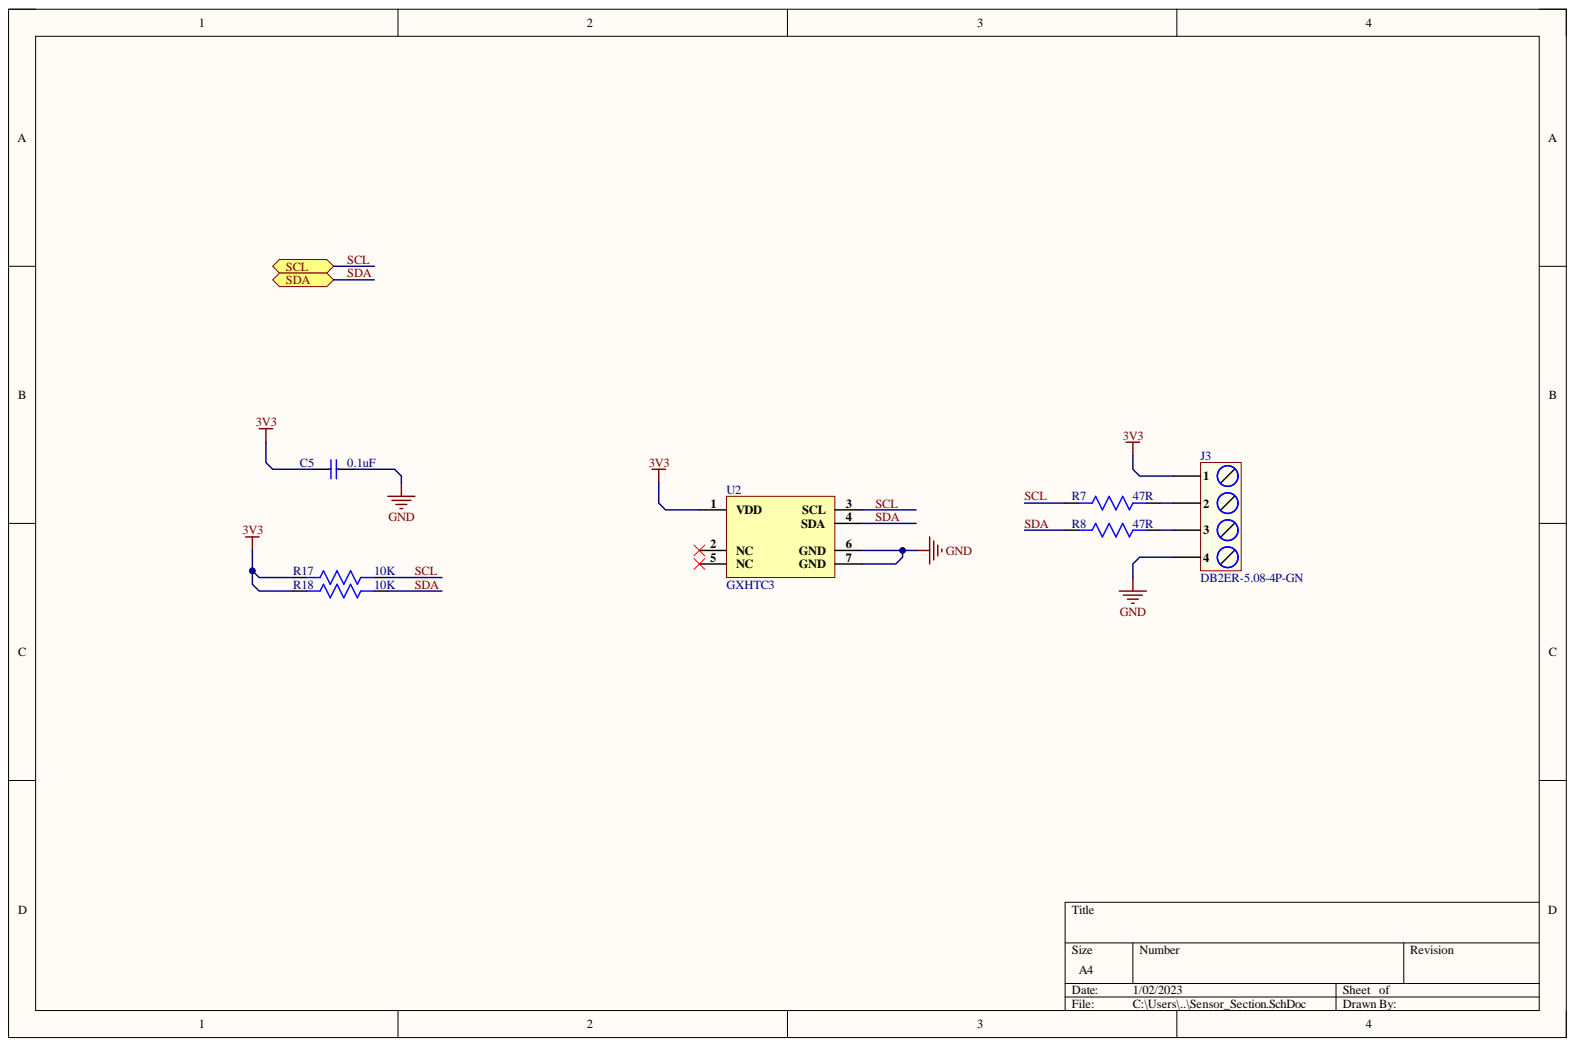
[picture p30: page 4]

Siz e A4 | Numb e r | R evisio n

Da te : 1/02/202 3 | She et of
File : C:\Use rs\. .\S ensor_S e cti o n . S c hD o c | Dr awn B y :

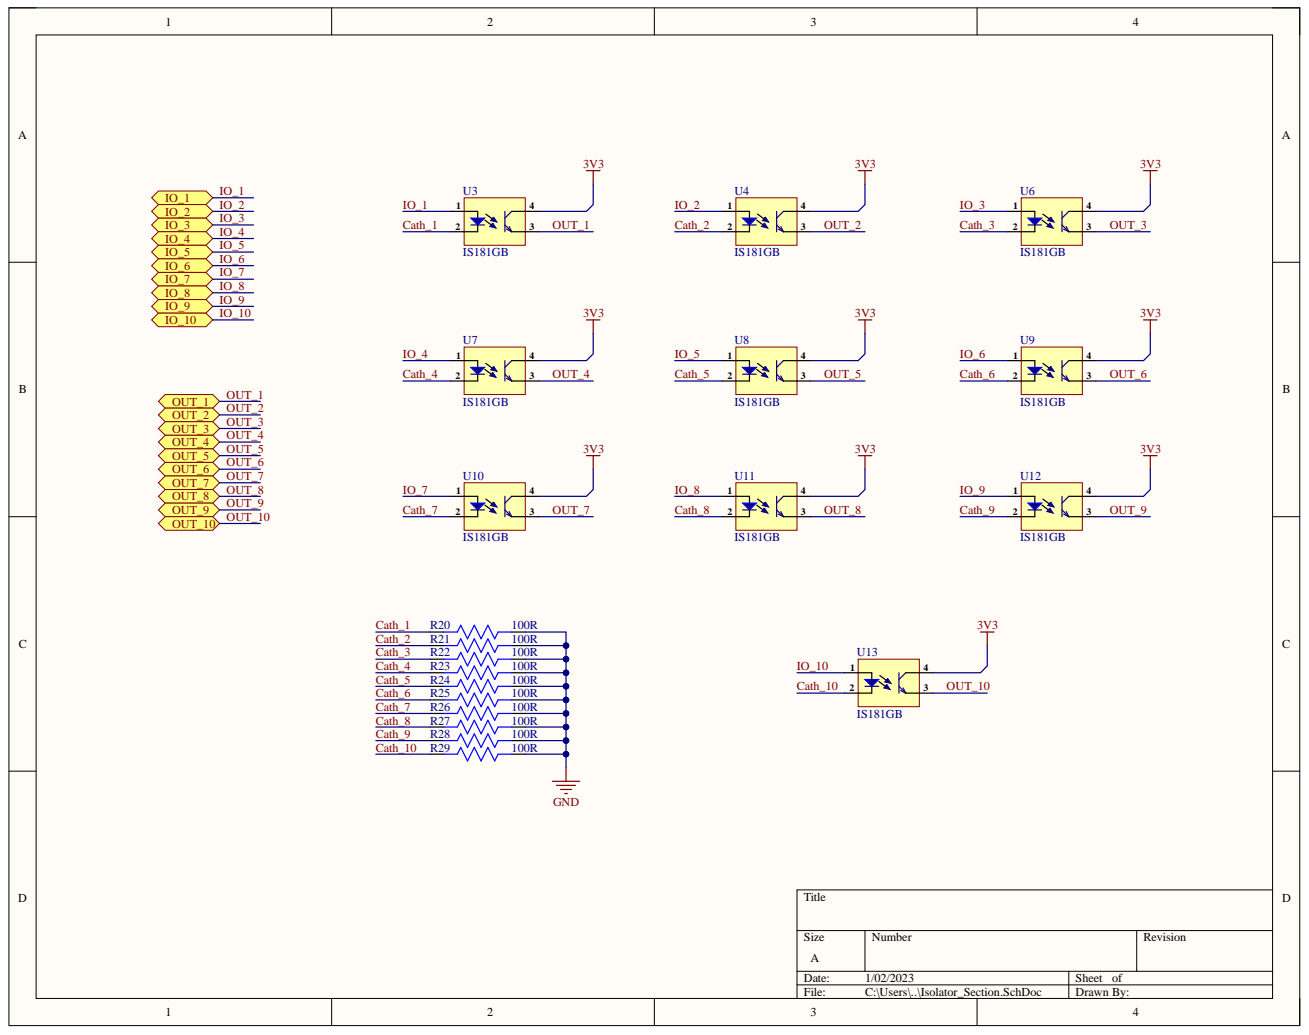
[picture p31: page 5]

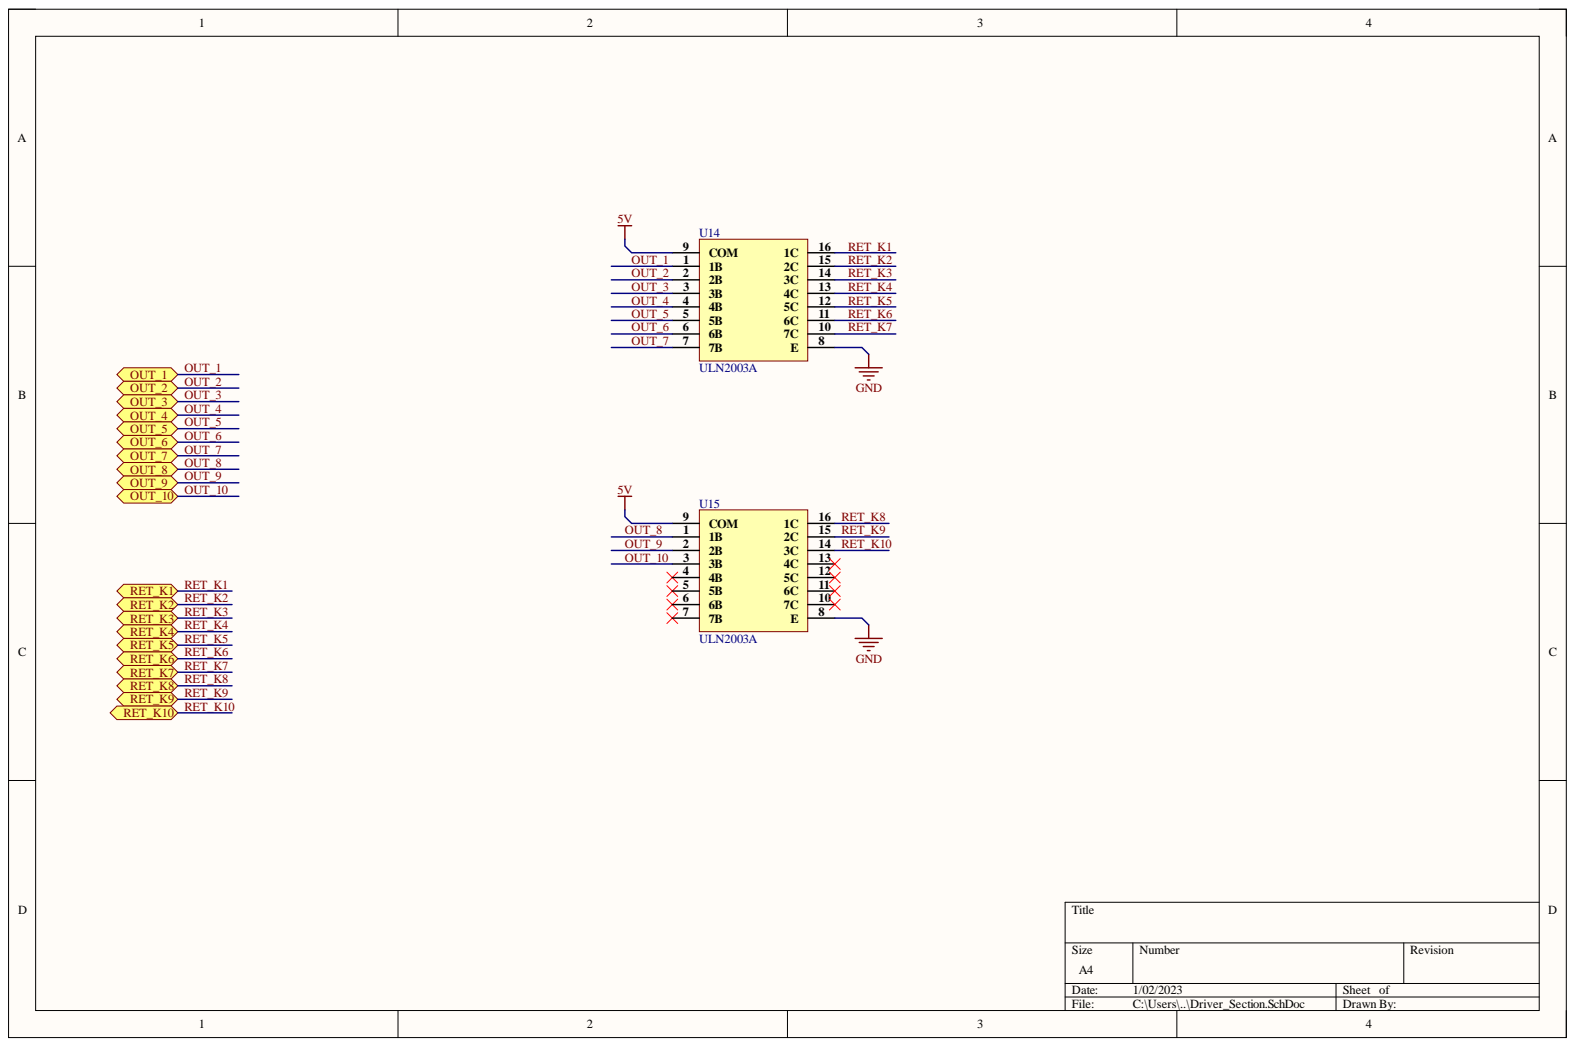
[picture p32: page 6]

Siz e A4 | Numb e r | R evisio n

Da te : 1/02/202 3 | She et of
File : C:\Use rs\. .\Drive r_S e c ti o n . S c hD o c | Dr awn B y :

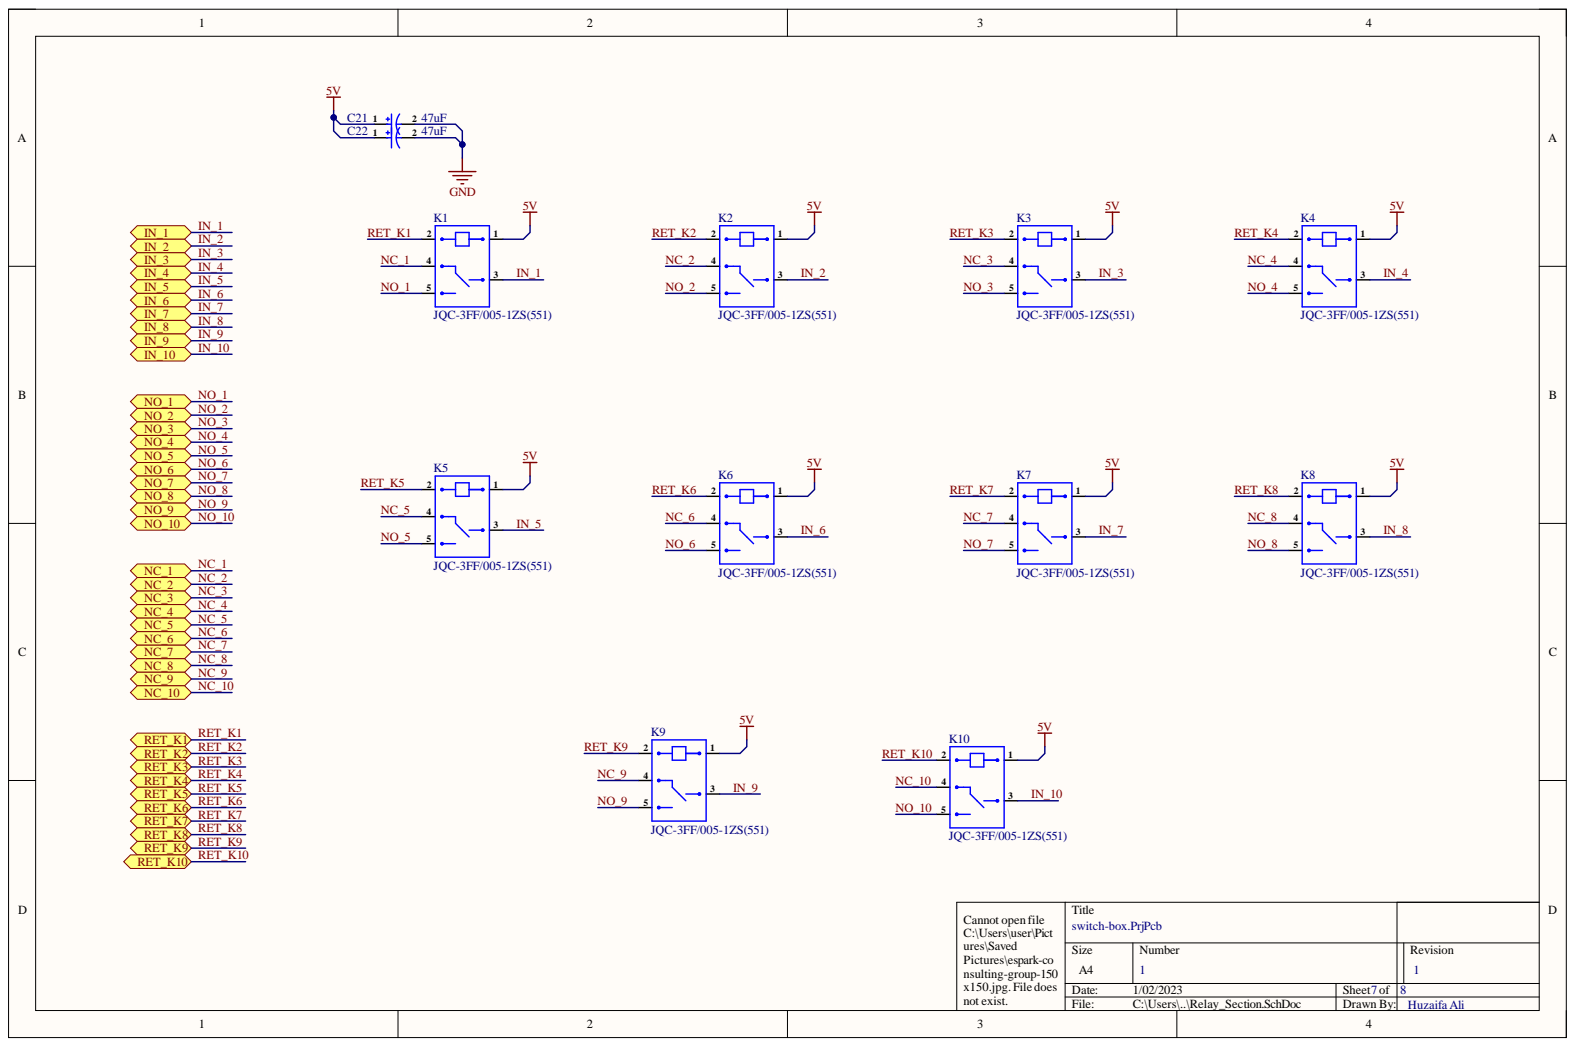
[picture p33: page 7]
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

Siz e A4 | Numb e r 1 | R evisio n 1

Da te : 1/02/202 3 | She et of 7 | 8
File : C:\Use rs\. .\R elay_S e cti o n . S c hD o c | Dr awn B y | : Huz aifa A li

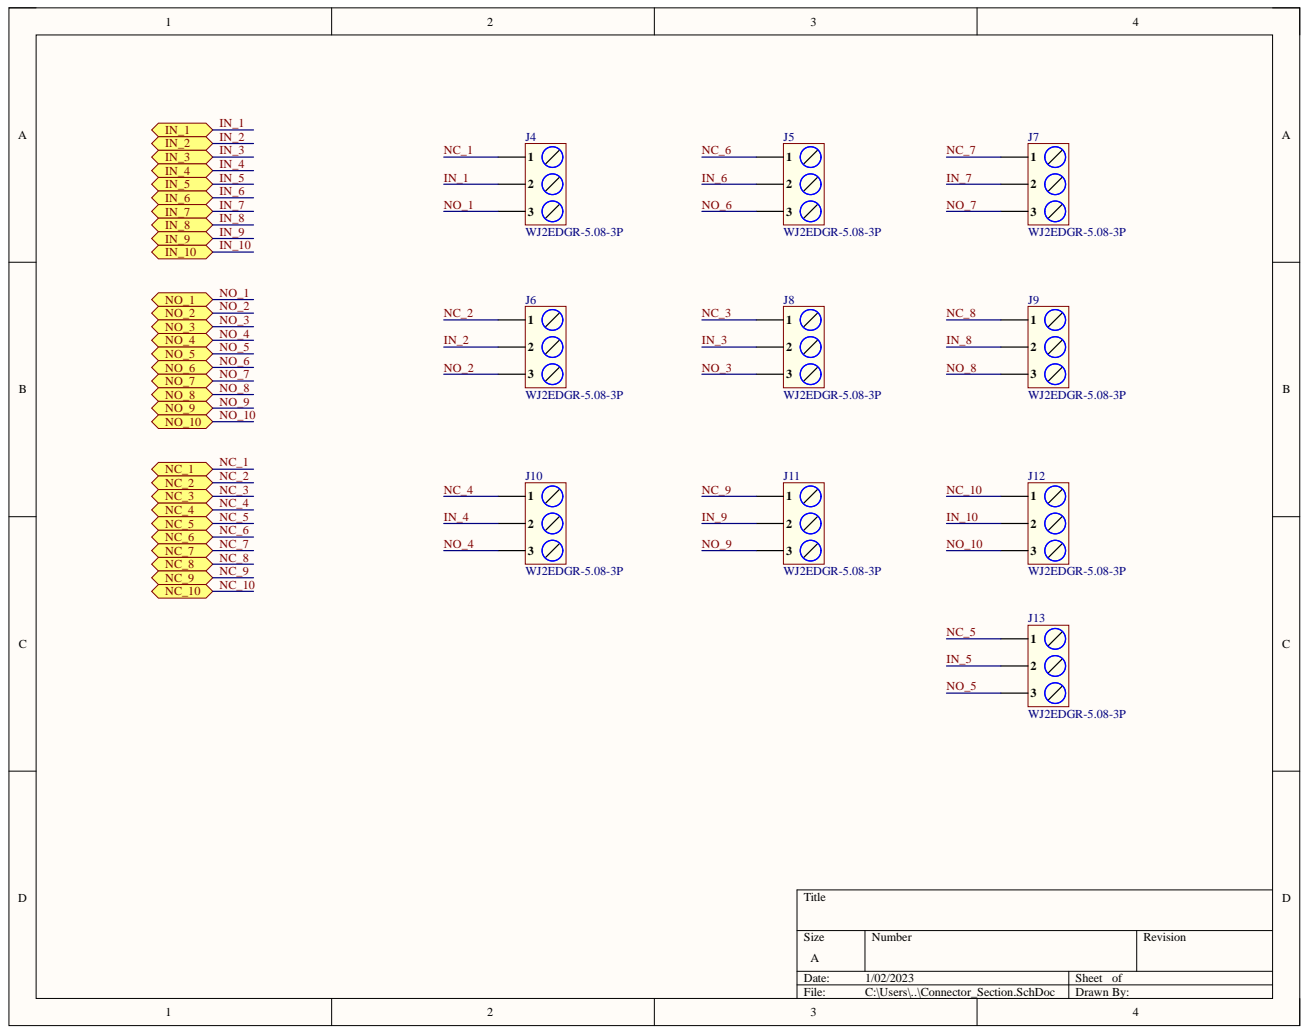
[picture p34: page 8]
