eSpark-Backup/ezlo-switchbox/(list of files, drawings)

Other design files:
Design-Files/Connector_Section.SchDoc
Design-Files/Controller_Section.SchDoc
Design-Files/Driver_Section.SchDoc
Design-Files/Isolator_Section.SchDoc
Design-Files/Relay_Section.SchDoc
Design-Files/Sensor_Section.SchDoc
Design-Files/switch-box.PcbDoc
Design-Files/switch-box.PrjPcb
Design-Files/Top_Sheet.SchDoc
Design-Files/USB & LDO_Section.SchDoc
docs/Files to share with client/SwitchBox RevA/Connector_Section.SchDoc
docs/Files to share with client/SwitchBox RevA/Controller_Section.SchDoc
docs/Files to share with client/SwitchBox RevA/Driver_Section.SchDoc
docs/Files to share with client/SwitchBox RevA/Isolator_Section.SchDoc
docs/Files to share with client/SwitchBox RevA/Relay_Section.SchDoc
docs/Files to share with client/SwitchBox RevA/Sensor_Section.SchDoc
docs/Files to share with client/SwitchBox RevA/switch-box.PcbDoc
docs/Files to share with client/SwitchBox RevA/switch-box.PrjPcb
docs/Files to share with client/SwitchBox RevA/Top_Sheet.SchDoc
docs/Files to share with client/SwitchBox RevA/USB & LDO_Section.SchDoc
