eSpark-Backup/ezlo-switchbox/(commit log)

2022-12-22 schematic design(in-progress) #2
    [Controller_Section.SchDoc, Top_Sheet.SchDoc, USB & LDO_Section.SchDoc, iR-Blaster_Section.SchDoc, iR_Receiver_Section.SchDoc, switch-box.PcbDoc, switch-box.PrjPcb]
2022-12-23 schematic design #2 (in-progress)
    [Controller_Section.SchDoc]
2022-12-23 #2 In-progress.
    [Controller_Section.SchDoc, Sensor_Section.SchDoc, Sheet1.SchDoc, USB & LDO_Section.SchDoc, iR-Blaster_Section.SchDoc, iR_Receiver_Section.SchDoc, switch-box.PcbDoc, switch-box.PrjPcb]
2022-12-25 Schematic (complete) #2
    [Connector_Section.SchDoc, Controller_Section.SchDoc, Driver_Section.SchDoc, Isolator_Section.SchDoc, Relay_Section.SchDoc, Sensor_Section.SchDoc, Top_Sheet.SchDoc, USB & LDO_Section.SchDoc]
2022-12-26 design PDF generated
    [Connector_Section.SchDoc, Controller_Section.SchDoc, Driver_Section.SchDoc, Isolator_Section.SchDoc, Relay_Section.SchDoc, Sensor_Section.SchDoc, Top_Sheet.SchDoc, USB & LDO_Section.SchDoc]
2022-12-26 project saved
    [switch-box.PrjPcb]
2022-12-26 #5 In progress
    [Connector_Section.SchDoc, Controller_Section.SchDoc, Driver_Section.SchDoc, Isolator_Section.SchDoc, Relay_Section.SchDoc, Sensor_Section.SchDoc, USB & LDO_Section.SchDoc, switch-box.PcbDoc]
2022-12-27 #5 In-progress.
    [Connector_Section.SchDoc, Controller_Section.SchDoc, Driver_Section.SchDoc, Isolator_Section.SchDoc, Relay_Section.SchDoc, Sensor_Section.SchDoc, Top_Sheet.SchDoc, USB & LDO_Section.SchDoc]
2022-12-27 Revert "#5 In-progress."
    This reverts commit c59d1a5b1ee8d700d18cd2c68e5cb74b189c6824.
    [Connector_Section.SchDoc, Controller_Section.SchDoc, Driver_Section.SchDoc, Isolator_Section.SchDoc, Relay_Section.SchDoc, Sensor_Section.SchDoc, Top_Sheet.SchDoc, USB & LDO_Section.SchDoc]
2022-12-27 complete #6
    [Connector_Section.SchDoc, Controller_Section.SchDoc, Driver_Section.SchDoc, Isolator_Section.SchDoc, Relay_Section.SchDoc, Sensor_Section.SchDoc, Top_Sheet.SchDoc, USB & LDO_Section.SchDoc]
2022-12-28 #5 Completed.
    [Connector_Section.SchDoc, Controller_Section.SchDoc, Driver_Section.SchDoc, Isolator_Section.SchDoc, Relay_Section.SchDoc, Sensor_Section.SchDoc, Top_Sheet.SchDoc, USB & LDO_Section.SchDoc]
2022-12-29 Generated pdf
    [Connector_Section.SchDoc, Controller_Section.SchDoc, Driver_Section.SchDoc, Isolator_Section.SchDoc, Relay_Section.SchDoc, Sensor_Section.SchDoc, Top_Sheet.SchDoc, USB & LDO_Section.SchDoc]
2022-12-29 #29 In progress
    [eSpark_BOM(10 pcs).xlsx, switch-box.PrjPcb]
2022-12-29 uln2003 IC corrected #9
    [Driver_Section.SchDoc]
2022-12-29 Altium project saved
    [switch-box.PrjPcb]
2022-12-29 #9 cutout for Relay generated
    [switch-box.PcbDoc]
2022-12-29 Screw terminals changed with pluggable types #9
    [Connector_Section.SchDoc, Controller_Section.SchDoc, Sensor_Section.SchDoc]
2022-12-29 Voltlink target replaced #9
    [Controller_Section.SchDoc]
2022-12-29 bulk capacitance added for relay #9
    [Relay_Section.SchDoc]
2022-12-29 #7 In progress
    [Driver_Section.SchDoc, eSpark_BOM(10 pcs).xlsx]
2022-12-29 fixed GND issue #9 (schematic changes complete)
    [Connector_Section.SchDoc, Controller_Section.SchDoc, Driver_Section.SchDoc, Isolator_Section.SchDoc, Relay_Section.SchDoc, Sensor_Section.SchDoc, Top_Sheet.SchDoc, USB & LDO_Section.SchDoc]
2022-12-29 #9 In-progress.
    [Connector_Section.SchDoc, Controller_Section.SchDoc, Driver_Section.SchDoc, Isolator_Section.SchDoc, Relay_Section.SchDoc, Sensor_Section.SchDoc, Top_Sheet.SchDoc, USB & LDO_Section.SchDoc]
2022-12-29 #9 Completed.
    [Connector_Section.SchDoc, Controller_Section.SchDoc, Driver_Section.SchDoc, Isolator_Section.SchDoc, Relay_Section.SchDoc, Sensor_Section.SchDoc, Top_Sheet.SchDoc, USB & LDO_Section.SchDoc]
2022-12-30 #8 DRC error remove and Deliverables generated
    [Pick Place for switch-box.csv, switch-box.DWG, switch-box.DXF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]
2022-12-30 #7 Completed
    [JLCPCB_BOM.xlsx, LCSC_BOM-(10 pcs).xlsx, eSpark_BOM(10 pcs).xlsx]
2022-12-31 #8 Done.
    [Connector_Section.SchDoc, Controller_Section.SchDoc, Driver_Section.SchDoc, Isolator_Section.SchDoc, Pick Place for switch-box.csv, Relay_Section.SchDoc, Sensor_Section.SchDoc, Top_Sheet.SchDoc]
2023-01-02 minor PCB corrections
    [Connector_Section.SchDoc, switch-box.PcbDoc]
2023-01-02 #8 In-progress.
    [Connector_Section.SchDoc, Controller_Section.SchDoc, Driver_Section.SchDoc, Isolator_Section.SchDoc, Pick Place for switch-box.csv, Relay_Section.SchDoc, Sensor_Section.SchDoc, Top_Sheet.SchDoc]
2023-01-02 #12 Update BOM and Centroid file Create Also.
    [Centroid-JLCPCB.csv, JLCPCB_BOM.xlsx, LCSC_BOM-(10 pcs).xlsx, LCSC_BOM.xlsx, eSpark_BOM(10 pcs).xlsx, eSpark_BOM.xlsx, switch-box.PcbDoc, switch-box.PrjPcb]
2023-01-02 switchbox centroid file corrected
    [Centroid JLCPCB.csv, Centroid-JLCPCB.csv, JLCPCB_BOM.xlsx, switch-box.PcbDoc, switch-box.PrjPcb]
2023-02-02 switch box pdf generated
    [switch-box.PrjPcb]
2023-02-07 #14 Peripheral Updated
    [eSpark_BOM.xlsx]
2023-02-07 #14 Parts Names Updated.
    [eSpark_BOM.xlsx]
